jiaweizhang/table/README.md

# table
VHDL implementation of network switch mac-address to port table with LRU eviction policy
