jiaweizhang/table/images/compare_rtl.PNG

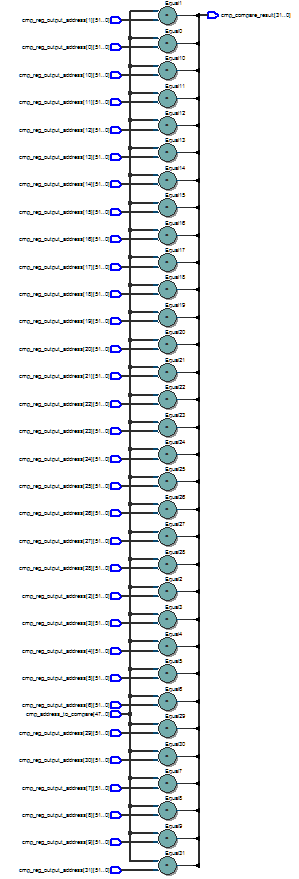
images/compare_rtl.PNG
