jiaweizhang/table/images/compute_rtl.PNG

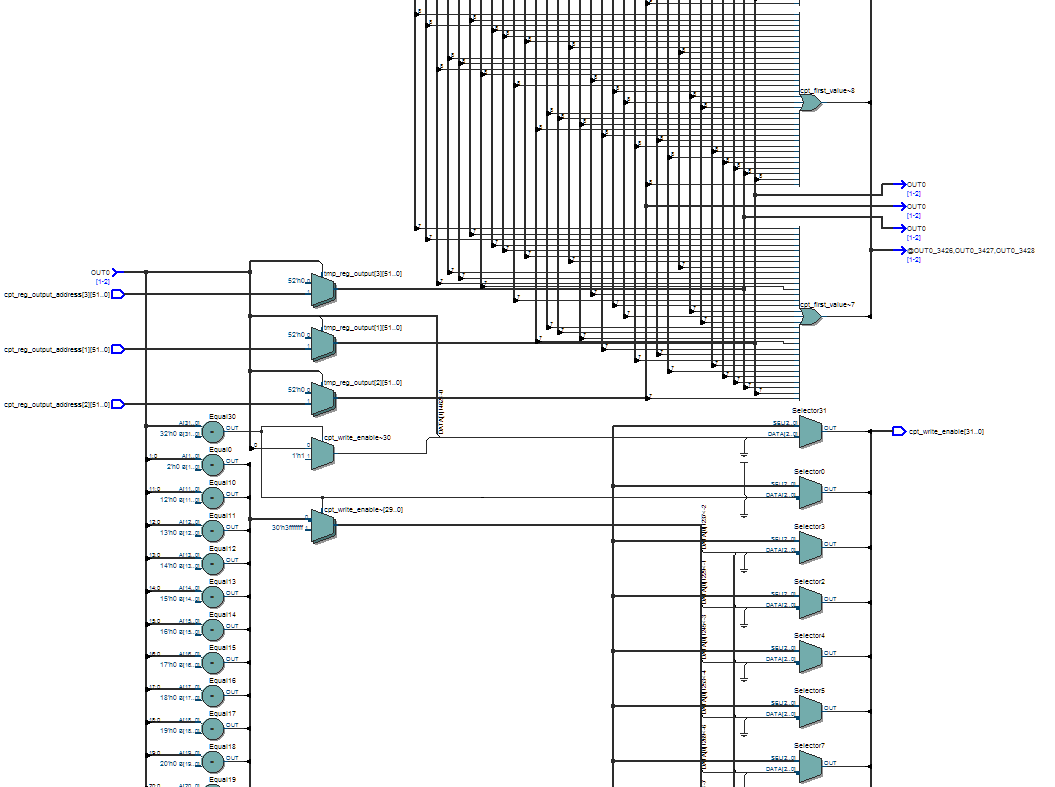
images/compute_rtl.PNG
