jiaweizhang/table/images/fsm_rtl.PNG

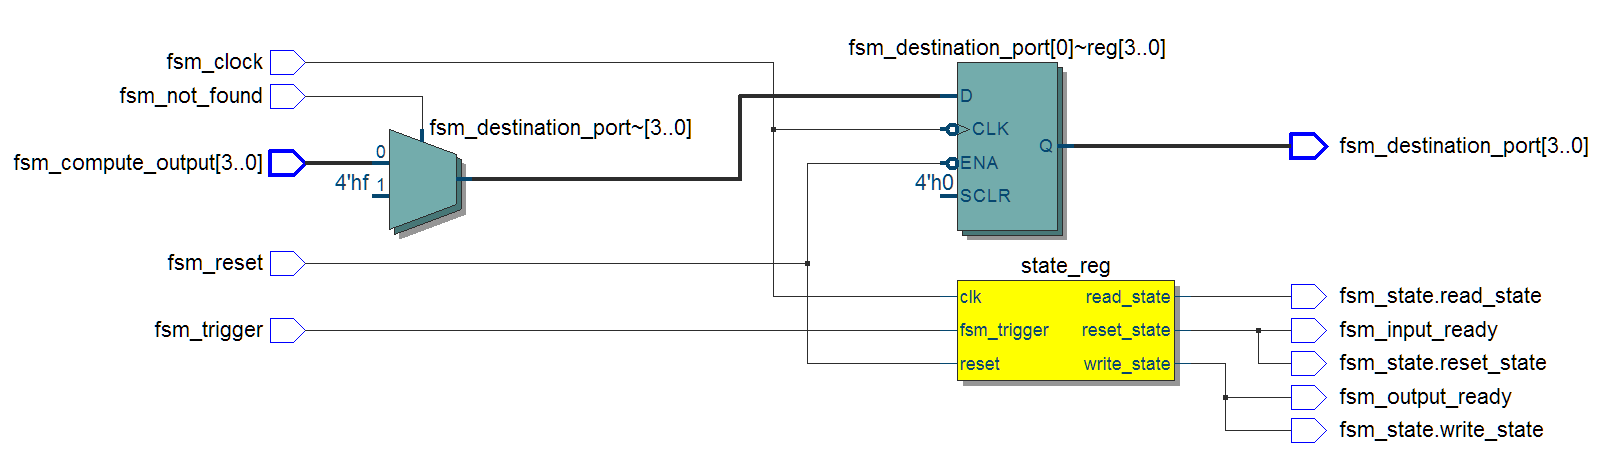
images/fsm_rtl.PNG
