jiaweizhang/table/images/fsm_state_transition_diagram.PNG

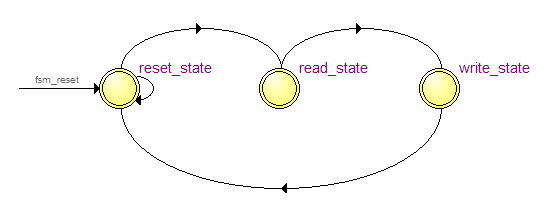
images/fsm_state_transition_diagram.PNG
