jiaweizhang/table/images/fsm_state_transition_table.PNG

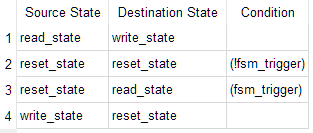
images/fsm_state_transition_table.PNG
