jiaweizhang/table/images/fsm_updated_state_transition_diagram.PNG

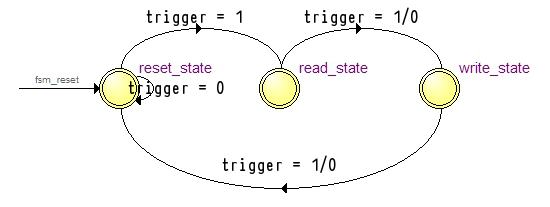
images/fsm_updated_state_transition_diagram.PNG
