jiaweizhang/table/images/hardware_1.PNG

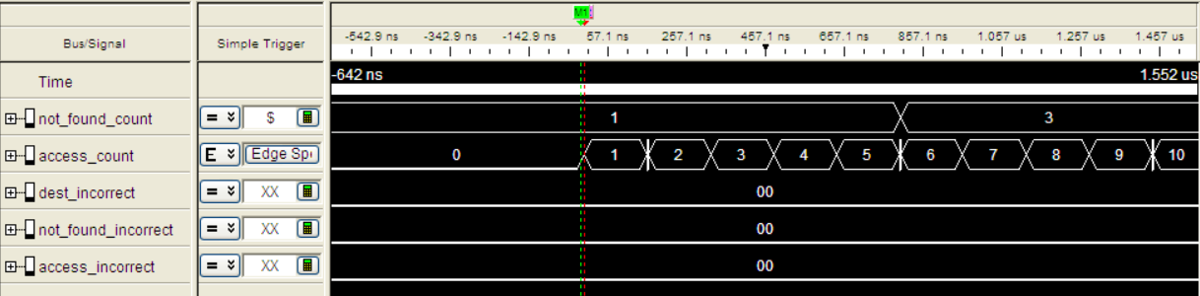
images/hardware_1.PNG
