jiaweizhang/table/images/hardware_2.PNG

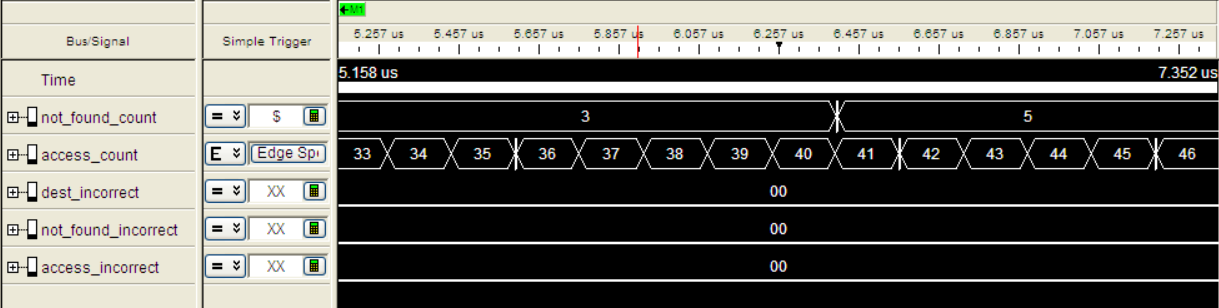
images/hardware_2.PNG
