jiaweizhang/table/images/register_chain_rtl.PNG

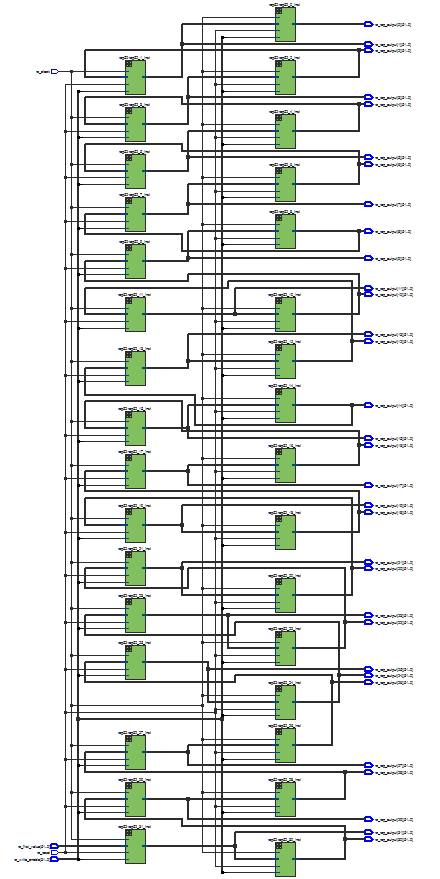
images/register_chain_rtl.PNG
