jiaweizhang/table/images/table_rtl.PNG

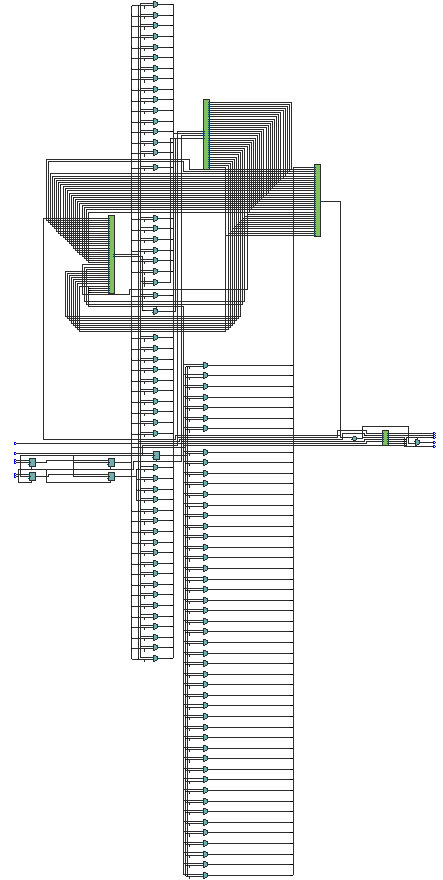
images/table_rtl.PNG
