jiaweizhang/table/(threads)

Thread 1 (2016-10-16):

compilation speed

jiaweizhang, 2016-10-16:
determine why compiling takes so long when using elsif chains

jiaweizhang, 2016-11-10:
Fixed using parallel OR

Closed 2016-11-10.
