jiaweizhang/table/(commit log)

2016-12-13 Added images, fixed memory test, fixed typos
    [address_table_hardware_memory_test.vhd]
2016-12-13 Finalized pin assignments
